combipatal/Digital-Cam/cam/test/origin image/background.jpg

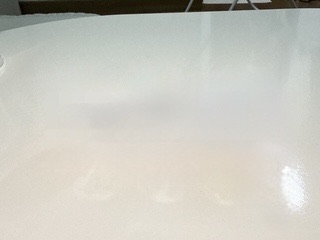
cam/test/origin image/background.jpg
