combipatal/Digital-Cam/cam/test/test.jpg

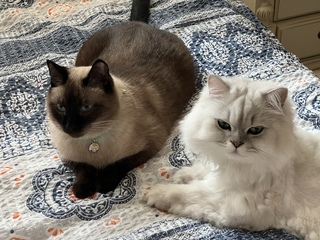
cam/test/test.jpg
