combipatal/Digital-Cam/프로젝트 플랜.docx

[프로젝트] FPGA를 활용한 실시간 이미지 프로세싱 시스템

OV7670 FPGA Image Processing System

- 기간: 2024.xx – 2024.xx (약 X개월)
- 역할: 단독 설계 및 구현 (RTL 설계, 시뮬레이션, 보드 디버깅 전 과정 수행)
- 플랫폼: Terasic DE2-115 (Intel Cyclone IV E), OV7670 카메라 모듈, VGA 모니터

FPGA를 활용한 실시간 이미지 프로세싱

- 툴: Intel Quartus Prime 24.1, Questa FSE
- 키워드: 실시간 영상처리, Multi-clock domain, Dual-port Frame Buffer, Pipelined Image Filter, Edge Detection, Color Tracking, Motion Detection

1. 프로젝트 개요

본 프로젝트의 목표는 FPGA 상에서 카메라 입력 영상을 실시간으로 처리하고, 다양한 영상처리 알고리즘을 하드웨어 파이프라인으로 구현하여 VGA 모니터에 출력하는 디지털 비디오 시스템을 설계하는 것이다.

FPGA를 활용한 실시간 이미지 프로세싱

주요 목적은 다음과 같다.

1. 실시간 처리 가능한 하드웨어 영상처리 파이프라인 구현
  - 1 pixel/clock 스트리밍 구조로 설계하여 실시간 처리 성능을 확보.
2. 여러 영상처리 알고리즘의 하드웨어 구현 및 비교
  - Gaussian Blur, Sobel, Canny, HSV 기반 Color Tracking, Adaptive Background 등.
3. FPGA 리소스 제약 내에서의 시스템 아키텍처 설계 역량 검증
  - 내부 BRAM 용량, 클럭 도메인 분리, 타이밍 이슈를 고려한 구조 설계.

2. 시스템 아키텍처

시스템은 카메라 입력부, 프레임 버퍼, 영상처리 파이프라인, VGA 출력부, IR 리모컨 제어부로 구성된다.

FPGA를 활용한 실시간 이미지 프로세싱

- 입력: OV7670 카메라 (RGB565, 약 30fps, PCLK ≈ 24 MHz)
- 버퍼링: Dual-port Frame Buffer RAM (카메라 PCLK 도메인 / VGA 25 MHz 도메인 분리)
- 처리 파이프라인:
  - Grayscale → Gaussian(3×3) → Sobel / Canny / Adaptive Background
  - RGB → HSV 변환 → Color Tracking
- 출력: VGA 640×480 @ 60 Hz (320×240 프레임을 2배 업스케일)
- 제어: IR 리모컨을 이용해 실시간으로 필터 모드를 변경 및 파라미터 조정

전체 파이프라인은 클럭당 1픽셀 처리를 목표로 설계되었으며, 각 필터 모듈의 내부 파이프라인과 지연 보상 회로를 포함한 전체 지연은 약 **9클럭(≈0.18 µs @ 50 MHz 기준)**로 정렬되도록 구성하였다.

FPGA를 활용한 실시간 이미지 프로세싱

3. 핵심 구현 내용

3.1 카메라 인터페이스 및 입력 처리

- ov7670_controller 설계
  - I²C 프로토콜을 RTL로 구현하여 OV7670 내부 레지스터 초기화.
  - 해상도 640×480, RGB565 모드로 동작하도록 설정.

FPGA를 활용한 실시간 이미지 프로세싱

- ov7670_capture 모듈
  - 카메라에서 들어오는 8-bit 단위 데이터 스트림을 수집하여 16-bit RGB565 픽셀로 재조립.
  - 내부 BRAM 용량 제약을 고려하여 2×2 Averaging 기반 Downsampling을 적용, 원본 640×480 → 320×240 프레임으로 축소하며 메모리 사용량을 절반으로 절감.

3.2 프레임 버퍼 및 멀티 클럭 도메인 설계

- frame_buffer_ram
  - Dual-port RAM을 사용해 **카메라 PCLK 도메인(write)**과 **VGA 도메인(read)**을 분리.

FPGA를 활용한 실시간 이미지 프로세싱

  - 읽기/쓰기 충돌 방지를 위해 주소 관리 및 프레임 단위 동기화 로직 설계.
- 프레임 동기화
  - OV7670의 vsync 신호를 이용해 “첫 프레임 쓰기 완료 후 VGA 읽기 시작” 구조로 변경하여 초기 프레임 깨짐 문제를 제거.

3.3 실시간 영상처리 파이프라인

각 필터는 모두 스트리밍 파이프라인 구조로 구현하여, 매 클럭마다 하나의 픽셀을 처리할 수 있도록 했다.

FPGA를 활용한 실시간 이미지 프로세싱

- gaussian_3x3_gray8
  - 3×3 Gaussian kernel을 적용하여 노이즈를 저감.
  - 뒤이어 수행되는 Sobel/Canny의 안정적인 엣지 검출을 위한 전처리 단계로 사용.
- sobel_3x3_gray8
  - 3×3 Sobel 연산자로 X/Y 방향 기울기를 계산.
  - 임계값 비교를 통해 강한 엣지를 추출.
- canny_3x3_gray8
  - Sobel 결과를 기반으로 Non-Maximum Suppression, Double Threshold를 구현.
  - 보다 얇고 노이즈에 강한 엣지 맵을 생성.
- rgb_to_hsv + color_tracker
  - 조명 변화에 덜 민감한 HSV 색 공간으로 변환 후, H/S/V 범위를 기준으로 특정 색(예: 빨강)을 마스크.
- adaptive_background
  - 현재 프레임과 배경 모델의 차이를 사용해 움직임을 감지.
  - 배경 학습률과 임계값을 파라미터로 두어, 조명 변화에 점진적으로 적응.

각 경로의 파이프라인 지연이 서로 다르기 때문에, 별도의 delay line을 삽입하여 모든 출력이 VGA 도메인의 기준 시점에서 +9clk에 정렬되도록 맞추었다. (페이지 6 타이밍 정렬 도표)

3.4 VGA 출력 및 업스케일링

- vga_640 모듈
  - 640×480 @ 60 Hz VESA 타이밍에 맞추어 HSYNC/VSYNC 및 유효 영상 구간을 생성.

FPGA를 활용한 실시간 이미지 프로세싱

  - 320×240 프레임 버퍼를 두 방향으로 2배 샘플링하여 VGA 해상도로 업스케일.
  - Frame Buffer read latency를 고려한 주소/데이터 타이밍 조정 구현.

3.5 IR 리모컨 기반 필터 제어

- IR_RECEIVER 모듈
  - NEC 프로토콜 기반의 IR 신호를 디코딩하여 8-bit 커맨드 코드로 변환.

FPGA를 활용한 실시간 이미지 프로세싱

  - 상위 모듈(digital_cam_top)에서 해당 코드를 해석해 필터 모드 전환, 예: 원본 / Gaussian / Sobel / Canny / Color Tracking / Adaptive BG 선택.
  - 하드웨어 실행 중에도 끊김 없이 필터 경로를 전환할 수 있도록 멀티플렉서 구조 설계.

4. 기술적 문제와 해결 사례

4.1 멀티 클럭 도메인으로 인한 프레임 깨짐

- 문제
  - 카메라 쓰기가 끝나기 전에 VGA가 같은 메모리 영역을 읽기 시작하면서, 화면 상단에 깨진 라인(half-updated frame)이 발생.

FPGA를 활용한 실시간 이미지 프로세싱

- 원인 분석
  - Dual-port RAM read latency 미반영.
  - 프레임 단위 동기화 없이 line 단위로만 동작.
- 해결
  - Frame Buffer read 경로에 FF를 추가해 read latency를 보상.
  - OV7670 vsync 상승 에지 이후 한 프레임이 모두 기록된 뒤에 VGA read를 시작하도록 프레임 카운터와 상태머신을 재구성.
- 결과
  - 프레임 깨짐 현상 제거, 안정적인 30fps 실시간 표시 확인.

4.2 Sobel 필터의 노이즈 증폭 및 타이밍 불일치

- 문제
  - 카메라 입력 노이즈가 Sobel 필터에서 과도하게 엣지로 인식되어 화면 전체가 들뜬 형태로 출력.
  - Gaussian, Sobel, Frame Buffer, VGA 사이의 파이프라인 지연이 불일치해 출력 타이밍이 어긋남.

FPGA를 활용한 실시간 이미지 프로세싱

- 해결
  - Sobel 입력을 Raw → Grayscale → Gaussian Blur를 거친 신호로 변경해 노이즈를 감소.
  - 각 모듈의 내부 지연을 정량적으로 계산하여, VGA 경로에 보상 파이프라인 삽입.
- 결과
  - 노이즈는 감소하고 객체 윤곽이 명확한 엣지 맵을 얻었으며, Sobel/Canny/원본 간 모드 전환 시에도 타이밍 mismatch 없이 부드럽게 출력.

4.3 BRAM 용량 한계와 SDRAM 시도

- 문제
  - 초기 목표는 640×480 전체 프레임을 내부 Frame Buffer에 저장 후 필터링하는 구조였으나, Cyclone IV 내부 BRAM 용량 한계로 단일 프레임 전체 저장이 어려움.

FPGA를 활용한 실시간 이미지 프로세싱

- 시도
  - 외부 SDRAM을 활용한 Frame Buffer 아키텍처를 설계하고, SDRAM Controller를 통해 읽기/쓰기 버스 구조를 구성하려고 함.
- 기술적 난점
  - SDRAM 초기화 시퀀스, 클럭 위상 관계, read/write 타이밍, refresh 관리 등에서 일정 내 안정적인 타이밍 closure를 달성하지 못함.
- 트레이드오프 및 최종 선택
  - 프로젝트 일정과 데모 안정성을 고려해, 외부 SDRAM 대신 2×2 Downsampling(320×240) + 내부 BRAM 기반 구조로 설계를 확정.
- 결과
  - 해상도는 절충했지만, 영상 품질 저하를 최소화하면서도 모든 필터를 실시간으로 안정 동작시키는 시스템을 구현.

5. 구현 결과

시스템은 다음과 같은 조건에서 데모를 완료하였다.

FPGA를 활용한 실시간 이미지 프로세싱

- 입력 영상
  - OV7670 카메라 실시간 입력 (실내/실외 환경, 정지/움직이는 객체).
- 출력
  - VGA 640×480 @ 60 Hz 해상도, 실시간 프레임 출력.
- 지원 모드 (IR 리모컨으로 선택)
  - Original, Grayscale, Gaussian, Sobel, Canny, Color Tracking, Adaptive Background.
- 자원 사용량 (DE2-115 기준)
  - Combinational functions: 39,008 / 114,480 (34%)
  - Logic registers: 49,819 / 114,480 (44%)
  - Memory bits: 1,929,252 / 3,981,312 (48%)

FPGA를 활용한 실시간 이미지 프로세싱

시뮬레이션(Questa)과 실제 보드 테스트를 통해
각 필터의 출력과 파이프라인 지연이 기대한 대로 동작함을 검증하였다.

6. 한계 및 향후 개선 방향

- 현재 구조는 320×240 내부 해상도를 기준으로 동작하므로, 향후에는 외부 SDRAM/SDRAM Controller를 안정화하여 640×480 full-frame 버퍼링을 구현하는 것이 목표다.
- Canny, Adaptive Background 등의 고급 알고리즘에 대해 fixed-point 연산 최적화 및 파이프라인 단계 재구성을 통해 리소스 효율을 높이는 여지가 있다.
- 다중 객체 색 추적, 영역 기반 후처리(Labeling 등)를 추가해 간단한 하드웨어 기반 비전 인식 시스템으로 확장 가능하다.

7. 프로젝트를 통해 얻은 역량

본 프로젝트를 통해 다음과 같은 역량을 실제로 체득했다.

FPGA를 활용한 실시간 이미지 프로세싱

1. Multi-clock domain 시스템 설계
  - 카메라–메모리–VGA 간 클럭 도메인 분리 및 동기화, 프레임 단위 제어 경험.
2. 하드웨어 파이프라인 최적화
  - 3×3 필터, 엣지 검출, 배경 추정 알고리즘을 클럭당 1픽셀 스트리밍 구조로 구현.
3. 타이밍/리소스 제약을 고려한 아키텍처 설계
  - BRAM 용량 한계와 외부 메모리 사용 여부를 비교·검토하여 구조를 결정.
4. 문제 분석 및 디버깅 능력
  - 프레임 깨짐, 노이즈 증폭, 타이밍 mismatch 등 시스템 레벨 문제를 분석하고 해결.
5. 사용자 인터페이스를 고려한 시스템 설계
  - IR 리모컨을 통한 실시간 모드 전환으로, 디버깅과 데모에 용이한 UI 구현.
