combipatal/Digital-Cam/cam/test/origin image/color_tracking.jpg

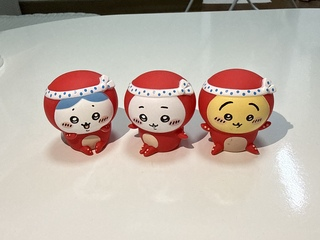
cam/test/origin image/color_tracking.jpg
