combipatal/Digital-Cam/cam/test/origin image/pinkbear.jpg

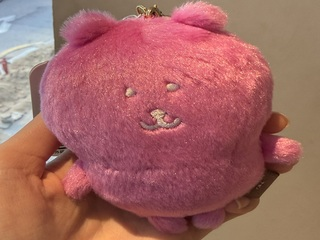
cam/test/origin image/pinkbear.jpg
