combipatal/Digital-Cam/cam/test/pink_bear.png

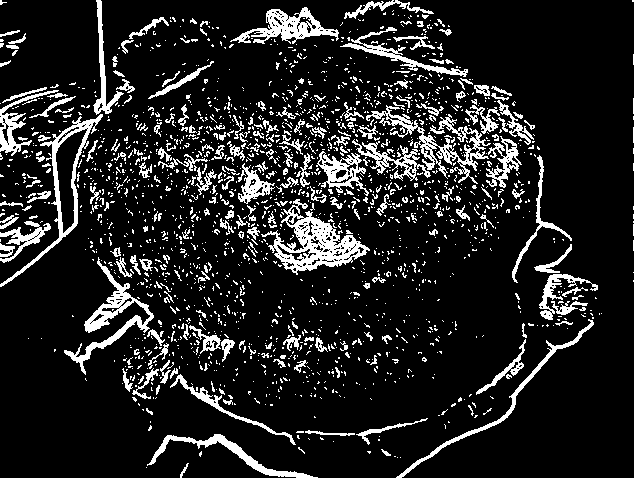
cam/test/pink_bear.png
