combipatal/Digital-Cam/cam/test/result_image/background.png

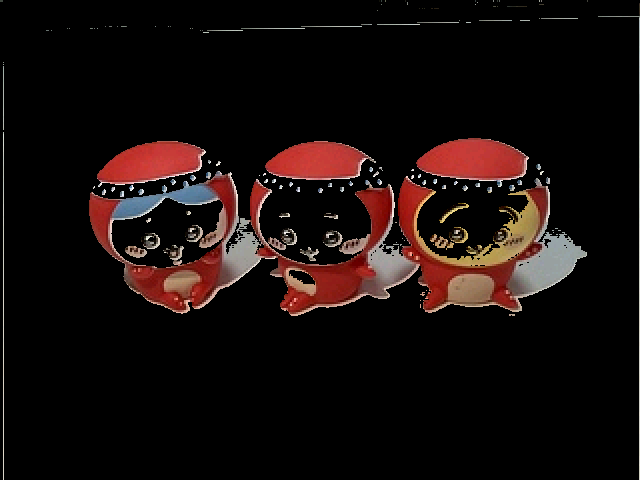
cam/test/result_image/background.png
