combipatal/Digital-Cam/cam/test/result_image/canny.png

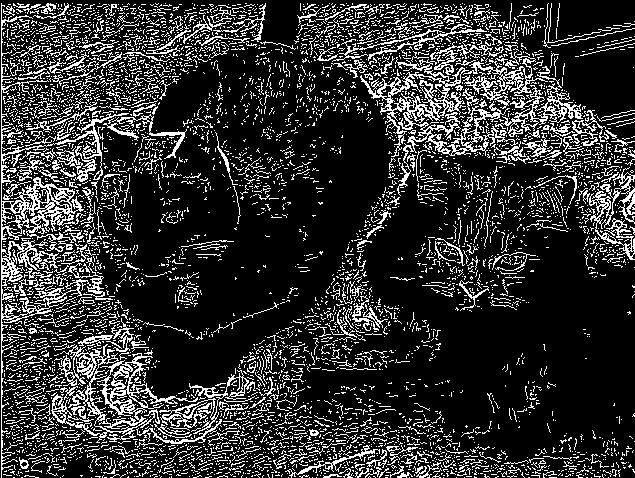
cam/test/result_image/canny.png
