combipatal/Digital-Cam/cam/test/result_image/color_tracking.png

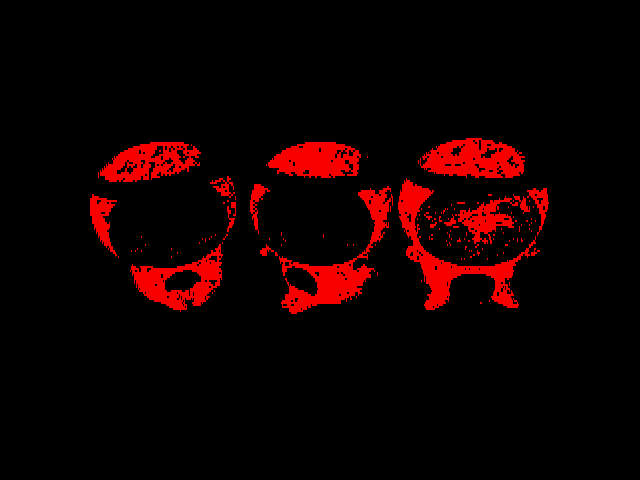
cam/test/result_image/color_tracking.png
