combipatal/Digital-Cam/cam/test/result_image/sobel.png

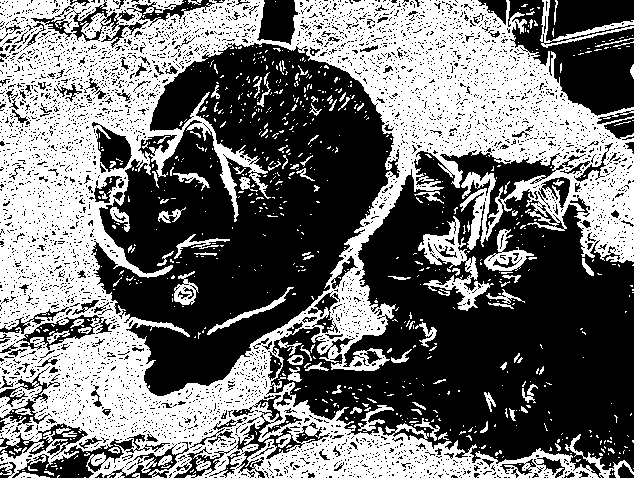
cam/test/result_image/sobel.png
