combipatal/Digital-Cam/(commit log)

2025-08-30 ir_Recevier 1차
2025-08-30 ir recevier 시간측정방식
2025-09-01 LCD & IR 수정
    [IR_RECEVER.v, LCD_1.v]
2025-09-03 Add VGA controller and PLL for 25MHz clock generation
    - Implemented a VGA module with 320x240 resolution at 60Hz.
    - Added a PLL module to generate a 25MHz clock from a 50MHz input.
    - Created a top-level module to integrate the VGA controller and PLL.
    - Defined pin assignments for the DE2-115 development board.
    - Included test patterns for VGA output, including color bars, checkerboard, gradient, and a moving square.
    - Updated project files (.qpf, .qsf) to reflect new design and settings.
2025-09-03 Add VGA controller and PLL clock module for VGA output
    - Implemented the PLL clock module (PLL_clk.v) for generating a 25MHz clock from a 50MHz input.
    - Created the top-level VGA module (vga_top.v) to handle VGA signal generation, including horizontal and vertical synchronization.
    - Added a clock divider to convert the 50MHz clock to 25MHz for VGA.
    - Developed a VGA controller to manage pixel coordinates and synchronization signals.
    - Integrated a pattern generator to display various patterns based on switch inputs.
    - Created a testbench (vga_top_tb) to simulate the VGA module and verify functionality.
    - Updated project files (.qpf and .qsf) to include new modules and settings.
2025-09-03 VGA 관련 모듈 및 테스트벤치 추가: 클럭 분배기, VGA 컨트롤러, 패턴 생성기, 테스트벤치 구현
2025-09-03 Add testbenches for video processing modules and update constraints
    - Implemented `pp_preprocess_tb.sv` for testing the pixel preprocessing module, including passthrough and grayscale conversion modes with assertions for output validation.
    - Created `ps_kernel_control_tb.sv` to test the kernel control logic, including output checks for multiple registers and data handling.
    - Developed `tb.sv` as a top-level testbench for the system, integrating camera input and validating data flow through the capture module.
    - Added `vtc_tb.v` to test the vertical timing controller, ensuring proper synchronization signals are generated.
    - Updated `test.xdc` with pin assignments for the Zybo Z7 board, includ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
2025-09-08 feat: Add initial camera-to-VGA project
    This commit introduces the initial Verilog source code and Quartus project files for an FPGA-based system to interface a camera sensor with a VGA display.
    It includes several project variations (`cam_vga_top`, `camera_vga`) containing the core modules for:
    - Camera configuration via I2C
    - Image data capture and buffering using a FIFO
    - VGA timing and signal generation
    - Clock management with a PLL
2025-09-08 Fix: Correct camera signal synchronization and configuration
    This commit resolves several issues related to camera signal handling and initialization to improve system stability and reliability.
    - **cam_vga_top:** Fix a critical clock domain crossing (CDC) issue. Camera signals (`cam_vsync_out`, `cam_wr`) are now properly synchronized to the `clk_25MHz` domain using a 2-stage synchronizer. This prevents metastability and ensures the debug status on the VGA output is accurate.
    - **cfg_rom:** Add a configuration value for the `COM10` register to explicitly set VSYNC and HREF polarity to positive. This ensures the camera module outputs signals with the expected polarity for correct frame capt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
2025-09-08 vhdl 카메라 코드
2025-09-09 verilog 수정,오류"
    :wq
    git push origin main
    [ov7670_capture.v, ov7670_controller.v]
2025-09-11 HDMI 수정
    HDMI -> VGA
2025-09-14 OV7670 카메라 인터페이스 및 캡처 모듈의 주석을 추가하고, 코드의 가독성을 높이기 위해 변수 및 신호에 대한 설명을 추가했습니다. VGA 컨트롤러와 관련된 타이밍 및 신호 생성 로직을 개선했습니다.
2025-09-14 모듈 및 파일 삭제: OV7670 카메라 관련 파일과 테스트 벤치, FPGA 소프트웨어 관련 파일을 삭제하여 코드베이스를 정리했습니다. 이로 인해 불필요한 파일이 제거되어 프로젝트의 관리가 용이해졌습니다.
2025-09-15 카메라 인터페이스 모듈 추가: OV7670 카메라의 픽셀 데이터를 캡처하는 'capture' 모듈, 카메라 관련 모듈을 통합하는 'cam_top' 모듈, 비동기 FIFO를 구현한 'fifo_async' 모듈, 그리고 FIFO 동기화 모듈인 'fifo_sync'를 추가했습니다. 이로 인해 카메라 데이터 처리 및 FIFO 관리 기능이 향상되었습니다.
2025-09-15 카메라 클럭 신호 수정: 카메라 모듈에서 50MHz 클럭을 24MHz 클럭으로 변경하고, 관련 신호 연결을 업데이트했습니다. 또한, RGB565에서 12비트로 변환하는 주석을 수정하여 RGB888로 변환하는 내용을 추가했습니다.
    [digital_cam_top.v, ov7670_capture.v, ov7670_controller.v]
2025-09-15 Update ov7670_controller.v
    line.74 주석 추가
2025-09-15 모듈 삭제 및 필터 업데이트: 고급 필터 및 간단한 필터 모듈을 삭제하고, RGB565 포맷에 맞춰 픽셀 데이터 처리 방식을 수정했습니다. 또한, 관련 파일에서 RGB565로의 변환을 반영하여 코드의 일관성을 높였습니다.
    [digital_cam_top.v, ov7670_capture.v]
2025-09-16 OV7670 컨트롤러 모듈의 주석 수정: SIOD 트라이스테이트 제어에 ACK 신호 판단 내용을 추가하여 코드의 이해도를 높였습니다.
    [digital_cam_top.v, gaussian_3x3_gray8.v, ov7670_controller.v, sobel_3x3_gray8.v]
2025-09-16 카메라 필터 및 모듈 업데이트: 기존 RGB888 필터를 RGB565로 변환하고, 소벨 및 가우시안 필터의 그레이스케일 처리 방식을 개선했습니다. 또한, 불필요한 필터 모듈을 삭제하여 코드베이스를 정리했습니다.
2025-09-17 그레이스케일 계산 개선: gray_sum의 비트폭을 11비트에서 17비트로 확장하여 정확도를 높였으며, gray_value의 계산 방식을 8로 나누기에서 256으로 나누기로 변경했습니다.
2025-09-17 VGA 컨트롤러 및 디지털 카메라 모듈 수정: 픽셀 데이터 및 주소 출력을 추가하고, 읽기 주소를 3클럭 지연시키는 로직을 구현했습니다. 또한, 불필요한 필터 모듈을 삭제하여 코드의 일관성을 높였습니다.
    [digital_cam_top.v, ov7670_controller.v, sobel_3x3_gray8.v]
2025-09-17 디지털 카메라 모듈 및 필터 개선: RAM 주소 계산 방식을 수정하고, VGA 동기화 신호 지연 로직을 추가했습니다. 또한, RGB888 변환 방식을 비트 복제로 변경하여 색상 품질을 개선했습니다. 그레이스케일 및 소벨 필터의 초기화 조건을 수정하여 안정성을 높였습니다.
    [digital_cam_top.v, gaussian_3x3_gray8.v, ov7670_capture.v, sobel_3x3_gray8.v]
2025-09-18 소벨 필터 초기화 조건 수정: 초기화 카운터의 조건을 5에서 2로 변경하고, 왼쪽 헤일로를 위한 유효 픽셀 수를 2에서 5로 조정하여 필터의 동작을 개선했습니다.
    [sobel_3x3_gray8.v]
2025-09-18 디지털 카메라 모듈 및 소벨 필터 수정: 파이프라인 지연 인덱스를 조정하고, 읽기 주소 동기화 로직을 개선했습니다. 또한, 소벨 필터의 수평 위치 레지스터를 9비트로 변경하여 메모리 사용을 최적화했습니다.
    [digital_cam_top.v, ov7670_capture.v, sobel_3x3_gray8.v]
2025-09-18 디지털 카메라 모듈 개선: 소벨 필터의 임계값 조절 기능을 추가하고, 가우시안 블러의 초기화 카운터를 수정하여 성능을 향상시켰습니다. 또한, 필터 처리 로직을 최적화하고, 불필요한 디지털 필터 모듈을 삭제하여 코드의 일관성을 높였습니다.
    [digital_cam_top.v, gaussian_3x3_gray8.v, sobel_3x3_gray8.v]
2025-09-19 디지털 카메라 모듈 업데이트: 캐니 엣지 검출 기능을 추가하고 (오류), 스위치 및 핀 할당을 수정하여 필터 모드 전환을 개선했습니다. 또한, 파이프라인 지연 인덱스를 조정하여 성능을 최적화했습니다.
    [canny_3x3_gray8.v, digital_cam_top.v]
2025-09-19 디지털 카메라 모듈 개선: 캐니 엣지 검출 로직을 최적화하고, 파이프라인 지연 인덱스를 조정하여 성능을 향상시켰습니다. 또한, 가우시안 필터의 초기화 카운터를 수정하고, 픽셀 입력 처리 방식을 개선하여 안정성을 높였습니다.
    [canny_3x3_gray8.v, digital_cam_top.v, gaussian_3x3_gray8.v, ov7670_capture.v]
2025-09-22 디지털 카메라 모듈 및 필터 개선: OV7670 카메라 인터페이스와 VGA 출력 신호를 통합하여 시스템 구조를 최적화했습니다. 또한, 가우시안 블러 및 소벨 필터의 입력 및 출력 신호를 개선하고, 버튼 디바운싱 로직을 정리하여 코드의 가독성을 높였습니다. VGA 컨트롤러의 타이밍 및 주소 생성 로직을 수정하여 성능을 향상시켰습니다.
    [digital_cam_top.v, gaussian_3x3_gray8.v, ov7670_capture.v, ov7670_controller.v, sobel_3x3_gray8.v]
2025-09-22 디지털 카메라 모듈 최적화: 그레이스케일 변환 로직을 하드웨어 효율성을 고려하여 곱셈 대신 시프트 및 덧셈으로 변경하였고, VGA 및 OV7670 모듈의 인스턴스화에서 코드 가독성을 향상시켰습니다. 또한, 불필요한 소벨 필터 및 캐니 엣지 검출 관련 코드 제거로 코드 정리를 진행했습니다.
2025-09-22 소벨 필터 임계값 조절 기능 추가: 버튼 디바운싱 로직을 구현하고, 소벨 임계값을 제어하는 로직을 추가하여 필터의 유연성을 향상시켰습니다. 또한, 가우시안 필터의 카운터 조건을 수정하여 코드의 안정성을 높였습니다.
    [digital_cam_top.v, gaussian_3x3_gray8.v]
2025-09-22 디지털 카메라 모듈 업데이트: 소벨 필터 및 캐니 엣지 검출을 위한 스위치 핀 할당을 추가하고, 불필요한 코드 및 주석을 정리하여 가독성을 향상시켰습니다. 또한, 가우시안 필터의 입력 처리 방식을 개선하여 안정성을 높였습니다.
2025-09-22 Revert "디지털 카메라 모듈 개선: 캐니 엣지 검출 로직을 최적화하고, 파이프라인 지연 인덱스를 조정하여 성능을 향상시켰습니다. 또한, 가우시안 필터의 초기화 카운터를 수정하고, 픽셀 입력 처리 방식을 개선하여 안정성을 높였습니다."
    This reverts commit ef235c61c590932db2357f18839cc744fd178721.
    [canny_3x3_gray8.v, digital_cam_top.v, gaussian_3x3_gray8.v, ov7670_capture.v]
2025-09-22 디지털 카메라 모듈 수정: RAM2의 읽기 주소를 rdaddress_sync에서 rdaddress_ram2로 변경하여 메모리 접근을 개선했습니다. - 왼쪽 흰색 줄, (타이밍) 가우시안 초기화 로직 수정,
    [digital_cam_top.v]
2025-09-23 디지털 카메라 모듈 개선: 메모리 주소 정렬 로직을 추가하여 RAM 접근을 최적화하고, 그레이스케일 및 소벨 필터의 입력 처리 방식을 개선했습니다. 또한, VGA 동기화 신호의 지연을 조정하여 데이터 경로와 일치시켰습니다.
2025-09-23 디지털 카메라 모듈 업데이트: 소벨 필터의 임계값 조절 기능을 위한 버튼 입력 핀 할당을 추가하고, 버튼 디바운싱 로직을 구현하여 필터의 유연성을 향상시켰습니다. 또한, 가우시안 필터의 입력 처리 방식을 개선하여 안정성을 높였습니다.
2025-09-28 ov7670_capture 모듈 수정
2025-09-29 OV7670 캡처 모듈에 2x2 평균 디시메이션 기능 추가 및 관련 주석 업데이트. 디지털 카메라 모듈의 픽셀 데이터 처리 방식을 개선하여 메모리 접근 최적화.
2025-09-30 (지연수정전) 워밍업 게이트 제거 ,, 소벨 필터의 입력 픽셀을 변경하여 처리 로직을 최적화했습니다. 그에 맞게 지연 추가, VGA 출력 연결 방식을 간소화하고, 관련 주석을 업데이트하여 코드 가독성을 향상시켰습니다.
    [digital_cam_top.v, ov7670_capture.v]
2025-09-30 첫 프레임 캡처 완료 후 VGA 출력을 활성화하는 로직을 추가하고, 클럭 도메인 간 동기화를 구현하여 안정성을 높였습니다.
2025-09-30 VGA ?쇱씤 寃쎄퀎 ?뺣젹 媛쒖꽑: rdaddress ?꾨━移댁슫???쇱씤 ?뚮컢???숆린 吏??議곗젙
2025-09-30 Fix VGA line boundary alignment: rdaddress pre-count, line warm-up, sync delay tuning
    [digital_cam_top.v]
2025-10-05 OV7670 캡처 모듈의 RGB565 픽셀 조립 로직을 개선하고, 2x2 평균 디시메이션 기능을 최적화했습니다. 또한, 관련 주석을 업데이트하여 코드 가독성을 향상시켰습니다.
2025-10-05 OV7670 카메라 인터페이스 모듈의 주석을 개선하고, 디지털 카메라 최상위 모듈에서 입력 및 출력 신호의 설명을 명확히 하였습니다. 또한, cam.qsf 파일에 타이밍 분석 및 스마트 재컴파일 설정을 추가하여 성능을 향상시켰습니다.
2025-10-05 (1차 완성본 )디지털 카메라 모듈의 파티션 설정을 추가하고, 카메라 캡처 및 필터 모듈의 구조를 개선했습니다. 또한, 디바운스 모듈을 삭제하여 코드의 간결성을 높였습니다. VGA 출력 신호 및 관련 로직을 최적화하여 성능을 향상시켰습니다
2025-10-07 필터 동작 오류 640
2025-10-07 Add 640x480 VGA upscaling path and update image filters
2025-10-07 (2차 완성본) 디지털 카메라 모듈의 메모리 지연 보정 로직을 최적화하고, 가우시안 필터의 커널 계산 방식을 개선했습니다. VGA 출력 신호의 활성 영역을 조정하여 성능을 향상시켰습니다. 또한, 관련 주석을 업데이트하여 코드의 가독성을 높였습니다.
2025-10-07 ir 동작 확인 , lcd 동작 확인 (한 문자에 2칸씩, 한줄만 작성되는 문제 발견)
2025-10-08 3차 완성본 (1픽셀 밀림 수정 완료)
    [digital_cam_top.v, ov7670_capture.v, vga_640.v]
2025-10-08 4차 완성본 (색 구별필터)
2025-10-08 5차 완성본 ( IR RECEVER 합성)
2025-10-09 불필요한 파일 제거
2025-10-09 6차 수정필요 (배경 검출파일 작성 , 수정 필요 )
    [digital_cam_top.v]
2025-10-09 6차 수정필요 (배경학습 로직 잘 동작 안함)
    [adaptive_background.v, digital_cam_top.v]
2025-10-10 6차 완성본 (배경 학슬 로직 동작 )( 하지만 밝은 곳에서는 기준값이 예민하고 어두운곳에서는 둔감하여 흰색 물체를 배경으로 인식하기 어려움)
2025-10-10 md 파일 갱신
2025-10-10 7차 수정본 ( 확인필요)
    [adaptive_background.v, digital_cam_top.v]
2025-10-10 7-2 수정본 ( 블루, 초록 필터 추가 (픽셀 색 변경 필요))(배경 감도 조절 추가 )
    [adaptive_background.v, color_tracker.v, digital_cam_top.v]
2025-10-11 7-3 수정본 (픽셀색 적용 완료 )(배경제거 로직 적응형 기준 추기 필요)
    [color_tracker.v, digital_cam_top.v]
2025-10-12 7-3수정본 ( 배경 제거 필터 구별 데이터 가우시안 필터로 변경 )( 동작 확인 필요 )
    [digital_cam_top.v]
2025-10-12 Enhance dynamic threshold logic in digital_cam_top.v for improved motion detection; convert background pixel to RGB888 and calculate luma for adaptive sensitivity based on brightness. Update threshol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
    [color_tracker.v, digital_cam_top.v]
2025-10-14 주석 수정과 고정된 파라미터 제거로 불필요한 로직 제거,
    [gaussian_3x3_gray8.v, ov7670_capture.v, ov7670_controller.v, sobel_3x3_gray8.v]
2025-10-14 포트폴리오 작성
2025-10-15 vga모듈 주석 수정 및 불필요한 로직 제거.
    [digital_cam_top.v, vga_640.v]
2025-10-15 top_module 중복 로직 삭제 및 레지스터 절약, 코드 위치 수정, 파이프라인 간략화 (주요 파이프라인 지연 오류 발견 수정 필요)
    [digital_cam_top.v]
2025-10-15 파이프라인 동기화 및 리소스 최적화를 위해 digital_cam_top.v를 리팩토링하고, 신호 지연을 정확하게 정렬하여 타이밍 버그를 수정했습니다. 쓸모없는 코드를 제거하고 적응형 백그라운드 캡처 로직을 간소화했습니다. 주석을 개선하고 불필요한 코드를 제거하여 명확성을 높였습니다.
    [digital_cam_top.v, vga_640.v]
2025-10-15 코드의 가독성을 높이기 위해 주석을 개선. 또한, 불필요한 파일삭제
2025-10-15 적응형 배경 제거 모듈의 주석을 한국어로 번역하고, 파라미터 설명을 명확히 하여 가독성을 향상시켰습니다. 파이프라인 단계 및 보조 함수에 대한 주석을 추가하여 코드 이해도를 높였습니다. 또한, 조합 논리 및 출력 측 로직에 대한 주석을 개선하여 코드의 명확성을 강화했습니다.
2025-10-16 주석 수정
2025-10-16 주석수정
2025-10-20 md 파일 수정
2025-10-27 적응형 배경 모델링 모듈을 그레이스케일 8비트 버전으로 변경하고, 관련 주석을 업데이트하여 코드 가독성을 향상시켰습니다. 파이프라인 구조를 4클럭에서 3클럭으로 최적화하고, RGB565에서 8비트 그레이스케일로 픽셀 데이터 폭을 수정했습니다. 또한, 불필요한 변수를 제거하고, 전경 판단 로직을 간소화하여 성능을 개선했습니다.
    [adaptive_background.v, digital_cam_top.v]
2025-10-27 전경 학습률 파라미터를 1/256로 수정하여 적응형 배경 모델의 성능을 개선했습니다. 또한, 새로운 8비트 프레임 버퍼 파일을 프로젝트에 추가하여 관련 모듈의 통합성을 높였습니다.
    [adaptive_background.v]
2025-10-27 배경 학습률 파라미터를 1/8에서 1/16으로 수정하여 적응형 배경 모델의 성능을 개선했습니다. 이 변경은 배경 픽셀의 빠른 적응을 더욱 효과적으로 지원합니다.
    [adaptive_background.v]
2025-11-01 캐니 주석 추가
2025-11-02 불필요한파일 제거
2025-11-03 소벨 + 캐니 시뮬레이션 완료
2025-11-03 가우시안 필터 시뮬레이션
2025-11-03 색 추적필터 시뮬레이션 완료
2025-11-04 배경제거 테스트 시나리오 강화 및 시뮬레이션 벤치 개선. `test_digital_cam_top.v`에서 배경제거 전경 마스크와 수직 동기를 외부 포트로 노출하고, 두 장의 프레임을 순차적으로 주입하여 결과를 캡처하도록 수정했습니다. `cam.qsf`에서 상위 모듈 이름을 변경하고, EDA 테스트 벤치 설정을 조정했습니다.
    [tb_digital_cam.v, test_digital_cam_top.v, vga_640.v]
2025-11-05 blank_N신호를 active_area와 동기화 하여 vga가 640 * 480 영상을 정확히 출력하도록 수정
    [adaptive_background.v, digital_cam_top.v, vga_640.v]
2025-11-06 소벨 테스트
2025-11-10 프로젝트 끝
2025-11-16 Remove all files except cam folder and README.md
    [cam.smp_dump.txt, stp1.stp]
2025-11-16 README.md 수정
2025-11-16 Clean up git repository: keep only main and test folders, remove build artifacts and project files from git tracking
    [cam.smp_dump.txt]
